Jur9x/Gate/README.md

# Gate
Maturitní projekt - *modelGate*

## Cíle:
* vytvoření modelu brány
* otevírání pomocí dálkového ovládání
* senzor na zamezení zavření

## Možné doplnění:
* otevírání na autentizaci spz
* overview v aplikaci na mobilu

## Použité technologie:

## Zdroje:
