Jur9x/Gate/dokumentace/sablona-zaverecne-prace.pdf

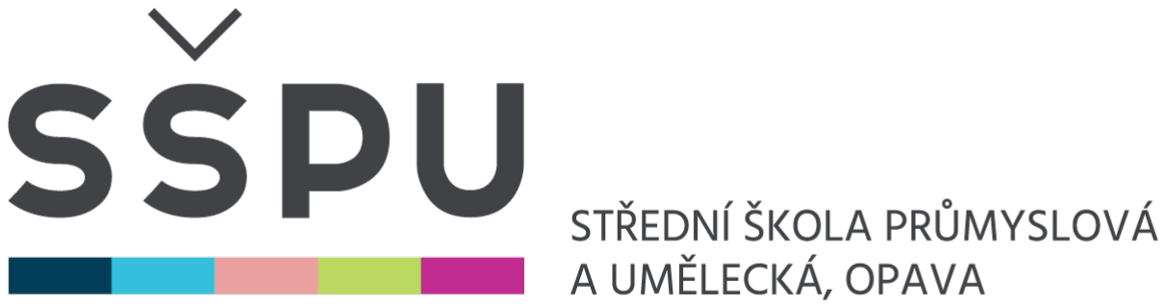
[picture p11: figure]

# ZÁVERE ˇ CNÁ STUDIJNÍ PRÁCE ˇ

### dokumentace

# modelGate

### posuvná brána s elektrickým pohonem

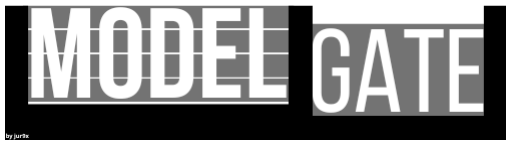
[picture p12: figure]

Autor: | Jiˇrí Ryba
Obor: | 18-20-M/01 INFORMACNÍ TECHNOLOGIE ˇ
se zameˇˇrením na pocíta ˇ cové sít ˇ | e a programování ˇ
Trída: ˇ | IT4
Školní rok: 2023/24

## Podekování ˇ

Rád bych podekoval u ˇ | citel˚um Mgr. Marcelu Godovskému a Mgr. Marku Lu ˇ | cnému za je- ˇ
jich pomoc s projektem, jelikož mi poskytovali soucástky a cenné rady. ˇ

### Prohlášení

Prohlašuji, že jsem závere ˇ cnou práci vypracoval samostatn ˇ | e a uvedl veškeré použité in- ˇ
formacní zdroje. ˇ
Souhlasím, aby tato studijní práce byla použita k výukovým a prezentacním ú ˇ | cel˚um na ˇ
Stˇrední pr˚umyslové a umelecké škole v Opav ˇ | e, Praskova 399/8. ˇ

V Opave 1. 1. 2024 ˇ
Podpis autora

## Abstrakt

Projekt se zameˇˇruje na kompletní realizaci posuvné brány s elektrickým pohonem, zahrnující návrh, modelování, sestavení a programování. Je zde využit mikrokontrolér Ar-
duino Nano, který umožnuje integraci s dálkovým ovládáním, koncovými spína ˇ | ci a sen- ˇ
zorem pohybu. Výsledkem projektu je plne funk ˇ | cní 3D model posuvné brány, schopný ˇ
reagovat na vstupy a poskytující efektivní automatizaci otevírání a zavírání.

### Klícová slova ˇ

Arduino Nano, modelování, programování, sestavení . . .

## Abstract

The project focuses on the complete implementation of an electrically operated sliding gate, including design, modelling, assembly and programming. An Arduino Nano microcontroller is used, which allows integration with remote control, limit switches and motion sensor. The project results in a fully functional 3D model of a sliding gate, capable of responding to inputs and providing efficient automation of opening and closing.

### Key words

Arduino Nano, modelling, programming, assembling . . .

# Obsah

Úvod | 5
1 Tvorba modelu | 6
1.1.1 | Výber softwaru | | 6 ˇ
1.1.5 | Modelování ozubeného kolecka a ozubené lišty | | 8 ˇ
1.1.6 | Modelování desticek a ˇ | cepi ˇ | cek | | 9 ˇ
2 Hardware | 11
3 Funkce modelu brány | 13
Záver | 18 ˇ

## ÚVOD

Cílem tohoto projektu bylo promenit myšlenku v realitu. Jednoho dne, když jsem ˇ | | ˇrešil
stavbu skutecné posuvné brány na rodinném pozemku, m ˇ | e napadlo, že bych podobný ˇ
koncept mohl zkusit vytvoˇrit jako menší projekt. Po schválení nápadu od všech ucitel˚u ˇ jsem se do toho pustil.

Pro samotné provedení modelu jsem vytvoˇril 3D modely, které mi vytiskl pan ucitel ˇ Mgr. Marcel Godovský na 3D tiskárne. Vytisknuté modely poskytly fyzickou podobu ˇ brány a umožnily snadné sestavení. Programování mikrokontroléru Arduino Nano bylo
klícovým krokem k dosažení ovládání brány. Vytvo ˇ | ˇril jsem ˇrídící algoritmus, který umož-
nuje plynulé otevírání a zavírání brány v reakci na externí podn ˇ | ety, nap ˇ | ˇríklad signály ze
snímac˚u nebo dálkového ovlada ˇ | ce. ˇ

Dokumentace obsahuje použité komponenty, zapojení a zp˚usob programování mikrokontroléru. Krome toho jsou zahrnuty i možné vylepšení projektu. Tato dokumentace slouží ˇ jako pr˚uvodce pro každého, kdo má zájem o pochopení a reprodukci podobného projektu posuvné brány s využitím Arduino technologie.

## 1 TVORBA MODELU

### 1.1 3D MODELOVÁNÍ

### 1.1.1 Výber softwaru ˇ

Pˇri výberu modelovacího softwaru pro m˚uj projekt jsem m ˇ | el na výb ˇ | er mezi n ˇ | ekolika ˇ
možnostmi, mezi nimiž byly klícovými kandidáty 3DS Max, Blender a Autodesk Inven- ˇ tor. Po d˚ukladném zvážení všech faktor˚u jsem se rozhodl pro Autodesk Inventor.

### 1.1.2 Výhody a nevýhody Autodesk Inventoru

Rozhodl jsem se využít Autodesk Inventor, díky mé pˇredchozí zkušenosti s tímto programem. Tato volba mi umožnila efektivní modelování bez nutnosti ucení se nového soft- ˇ waru. Díky studentské licenci poskytnuté školou jsem nemusel platit za software. Autodesk Inventor, specializovaný na inženýrství a konstrukci, odpovídá potˇrebám mého projektu s parametrickým modelováním a vhodnými nástroji. I když m˚uže být v umeleckém ˇ
modelování omezený ve srovnání s nekterými um ˇ | eleckými softwary, pro mé konkrétní ˇ
potˇreby a s ohledem na rychlý a efektivní postup modelování s minimální casovou inves- ˇ ticí byla tato volba rychlá a optimální.

### 1.1.3 Modelování konstrukce

V pˇrípade b ˇ ežné brány se brána y obvykle pohybuje po kole ˇ | cku a je usm ˇ | erˇ nována vá- ˇ
lecky. S t ˇ | emito dv ˇ | ema problémy jsem se musel vypo ˇ | ˇrádat. První výzvu jsem ˇrešil tím, že
jsem namísto kolecka vytvo ˇ | ˇril trojúhelníkovou drážku, po které brána jezdí. Díky nízké
váze brány není tˇrení témeˇˇr žádné, což je ideální. Druhý problém jsem eliminoval tím,
že jsem nahradil válecky pevnými body v konstrukci. Nakonec jsem vytvo ˇ | ˇril místa pro
motor, koncové spínace, senzor pohybu a drážky pro desti ˇ | cky. ˇ


Obrázek 1.1: Model konstrukce

### 1.1.4 Modelování brány

V procesu modelování brány jsem vytvoˇril samotnou bránu, vybavil ji trojúhelníkovou drážkou pro pojezd a výstupkem pro kontakt s koncovým spínacem. ˇ


Obrázek 1.2: Model brány

### 1.1.5 Modelování ozubeného kolecka a ozubené lišty ˇ

Pro ozubené kolecko jsem vytvo ˇ | ˇril obdélníkovou díru pro umístení motoru a kolem ob- ˇ
vodu kola jsem vytvoˇril zuby. Ozubená lišta má stejnou délku jako brána a je opatˇrena
zuby shodnými s temi na ozubeném kole ˇ | cku. ˇ


Obrázek 1.3: Model ozubeného kolecka ˇ


Obrázek 1.4: Model ozubené lišty

1.1.6 Modelování desticek a ˇ | cepi ˇ | cek ˇ
Na desticky jsem p ˇ | ˇridal malé výcnˇ elky na obou koncích, vytvá ˇ | ˇrející malý rozestup mezi
jednotlivými destickami. V ˇ | cepi ˇ | ckách je vyhrazeno místo pro LED diody a prostor pro ˇ
drátky. Tyto drátky vedoucí k diodám jsou oddeleny tak, aby nedošlo k dotyku mezi klad- ˇ ným a záporným pólem.


Obrázek 1.5: Model desticky ˇ


Obrázek 1.6: Model cepi ˇ cky ˇ

## 1.2 3D TISK

3D tisk je inovativní výrobní proces, který umožnuje vytvá ˇ | ˇret tˇrírozmerné objekty vrstvu ˇ
po vrstve na základ ˇ | e digitálního modelu. Tento postup eliminuje pot ˇ | ˇrebu tradicního od- ˇ
stranování materiálu a umož ˇ | nuje vytvá ˇ | ˇret komplexní a pˇresné objekty s r˚uznorodými ge-
ometriemi. 3D tisk m˚uže využívat r˚uzné materiály, vcetn ˇ | e plast˚u, kov˚u, keramiky a bio- ˇ
logických tkání, což poskytuje široké možnosti aplikací od pr˚umyslové výroby a prototypování po zdravotní péci a výzkum. Tento inovativní proces zrychluje vývojové cykly ˇ a umožnuje tvorbu unikátních a složitých design˚u s minimálním odpadem. ˇ

### 1.3 SESTAVOVÁNÍ MODELU

Pˇripevnil jsem ozubenou lištu na bránu. Motor s ozubeným koleckem, desti ˇ | cky, ˇ | cepi ˇ | cky, ˇ
koncové spínace a senzor pohybu jsem p ˇ | ˇrilepil na vytiskutý model pomocí tavící pistole.
Nakonec jsem celý model pˇrilepil na dˇrevené desky, kde jsem rovn ˇ | ež p ˇ | ˇridal dve kontaktní ˇ
pole, h-m˚ustek a následne vše zapojil. ˇ


Obrázek 1.7: Ukázka sestavení modelu

## 2 HARDWARE

Výber hardwaru prob ˇ | ehl rychle a jednoduše, nebot’ jsem se rozhodl použít Arduino Nano, ˇ
které jsme již využívali ve škole. Následne mi chyb ˇ | ely pouze n ˇ | ekteré komponenty, které ˇ
mi vstˇrícne poskytl pan u ˇ | citel Mgr. Marcel Godovský. ˇ

### 2.1 SEZNAM POUŽITÉHO HARDWARU

1x Arduino Nano Mikrokontrolér

2x DM00 (DM 03S) Koncové spínaceˇ

1x L298N H-M˚ustek, umožnuj ˇ e mˇ enit polarity motoru ˇ

1x 5V motor

3x LED

3x 330R Rezistor

3x 1k Rezistor

1x HW-201 Senzor pohybu

1x VS1838B IR pˇrijímacˇ

1x Vytisknutá konstrukce

1x Vytisknutá brána

1x Vytiskunté ozubené kolecko ˇ

1x Vytisknutá ozubená tycˇ

4x Vytisknuté plotové desticky ˇ

3x Vytisknuté cepi ˇ cky na plot ˇ

### 2.2 SCHÉMA HARDWARU

Schéma je koncipováno s cílem dosáhnout co nejvetší p ˇ ˇrehlednosti, a proto se nemusí shodovat s reálným uspoˇrádáním komponent v modelu.


Obrázek 2.1: Schéma zapojení

### 2.3 ARDUINO

Arduino je open-source projekt, který je založen na snadno použitelném hardwaru a soft-
waru. Arduino desky mají schopnost císt r˚uzné vstupy, jako nap ˇ | ˇríklad svetlo na senzoru, ˇ
stisknutí tlacítka nebo dokonce zprávy z Twitteru, a p ˇ | ˇremeˇnovat je na odpovídající vý- ˇ
stupy. To m˚uže zahrnovat aktivaci motoru, rozsvícení LED nebo dokonce publikaci ne-ˇ ceho online. S Arduino deskou m˚užete komunikovat pomocí instrukcí, které posíláte do ˇ mikrokontroléru. K tomu využíváte programovací jazyk Arduino a speciální vývojové prostˇredí Arduino Software (IDE).

### 2.4 PROBLÉMY S HARDWAREM

Ovladac ne ˇ | cekan ˇ | e p ˇ ˇrideloval r˚uzné kódy na jedno tla ˇ | cítko, což bylo trochu zvláštní. Toto ˇ
se stávalo po urcité dob ˇ | e testování, a ob ˇ | cas to fungovalo, zatímco jindy ne. Opravit tento ˇ
problém se ukázalo být složitejší, než jsem p˚uvodn ˇ | e o ˇ cekával, a tak jsem se rozhodl ho ˇ
zatím neˇrešit. Celkove však ovlada ˇ | c pracuje správn ˇ | e p ˇ ˇribližne 90 % ˇ | casu. ˇ
Problém s motorem a proudem vznikl, když jsem p˚uvodne plánoval napájet motor p ˇ | ˇres
Arduino. Nicméne jsem si neuv ˇ | edomil, že Arduino poskytuje pouze omezený proud (asi ˇ
200 mA), zatímco motor, který používám, vyžaduje alespon 500 mA. To m ˇ | e vedlo k hle- ˇ
dání externího napájení, a nakonec mi pan ucitel Mgr. Marcel Godovský poskytl 5V zdroj, ˇ což je výhodné, protože z nej mohu napájet i Arduino. ˇ

## 3 FUNKCE MODELU BRÁNY

Model brány má nekolik základních funkcí, které by m ˇ | el obsahovat každý bránový sys- ˇ
tém. To zahrnuje otevírání, zavírání a zastavování na povel z dálkového ovládání. Dále
umí zastavit na základe reakce na senzor pohybu. Krom ˇ | e toho model disponuje t ˇ | ˇremi
LED diodami, které signalizují aktuální stav brány.
3.1 OTEVRENÍ ˇ | , ZAVRENÍ A ZASTAVENÍ ˇ
Pro aktivaci jedné z techto funkcí je nezbytné stisknout p ˇ | ˇríslušné tlacítko na dálkovém ˇ
ovládání. Následne IR p ˇ | ˇrijímac detekuje signál a p ˇ | ˇriˇradí mu specifický kód. Na základeˇ
tohoto kódu tlacítka a dalších podmínek, jako jsou koncové spína ˇ | | | ce nebo senzor pohybu, ˇ
rozhodne programový kód, zda se motor má roztocit ˇ ci nikoli. V p ˇ | ˇrípade rozhodnutí pro ˇ
roztocení je do motoru správn ˇ | e p ˇ ˇrivedeno napetí, aby se pohyboval ve správném sm ˇ | | | eru. ˇ
Aby byl IR pˇrijímac funk ˇ | cní, je t ˇ | ˇreba zahrnout knihovnu | IRremote.h , nastavit pin
pˇripojený k pˇrijímaci (nap ˇ | ˇríklad | const int RECV_PIN = 12 | ), tento pin definovat pro
IRrecv ( IRrecv irrecv(RECV_PIN) ), vytvoˇrit promennou pro ukládání výsledk˚u a ak- ˇ
tivovat ho pomocí | irrecv.enableIRIn() . Podmínka | if | uloží kód do | results , po-
kud obdrží signál.

# i n c l u d e < IRremote . h> / / knihovna k IR p r i j i m a c i

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

Pro další postup je nutné konfigurovat koncové spínace; o senzoru pohybu bude podrob- ˇ
neji pojednáno v následující ˇ | cásti. Nastavení pin˚u je identické s tím u IR p ˇ | ˇrijímace, s tím ˇ
rozdílem, že v setupu nastavíme tyto dva piny jako | INPUT .

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

/ / p o v o l e n i pinu , p i s e se do s e t u p u pinMode ( Button_Levy_Pin , INPUT ) ;
pinMode ( Button_Pravy_Pin , INPUT ) ;
Vytvoˇríme promenné pro koncové spína ˇ | ce a senzor, abychom zabránili duplikaci kódu. ˇ

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

Vytvoˇríme podmínky pro spouštení a zastavování motoru, kde prom ˇ | enná ˇ | n | urcuje stav ˇ
motoru. První podmínka se ptá, zda je senzor aktivní ci ne. Druhá podmínka kontroluje, ˇ
zda je aktivní | STOP_CODE . Tˇretí podmínka zkoumá, zda není aktivní ani | OPEN_CODE ,
ani | CLOSE_CODE . S každým pr˚uchodem smyckou se kód resetuje, a tím pádem tato pod- ˇ
mínka zacne platit, což umožní koncovým spína ˇ | c˚um zastavit motor p ˇ | ˇri jejich aktivaci.
Ctvrtá podmínka se ptá, zda je vždy jeden spína ˇ | c sepnutý a druhý nikoli. Toto zajistí ˇ
zastavení motoru, když se jeden ze spínac˚u sepne. Pátá podmínka ov ˇ | eˇˇruje, zda je asponˇ
jeden nebo žádný spínac sepnutý. Toto je implementováno z d˚uvodu, že brána je obvykle ˇ
na konci a má spínac sepnutý, nebo je uprost ˇ | ˇred cesty a spínace nejsou sepnuté. ˇ

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

Tocení motoru ve správném sm ˇ | eru vy ˇ | ˇrešíme porovnáním, které tlacítko na ovlada ˇ | ci bylo ˇ
stisknuto, a pˇriˇradíme odpovídající smer do prom ˇ | enné ˇ | direction . Pˇri tomto procesu
také resetujeme promennou ˇ | results , abychom zajistili správnou funkcnost programo- ˇ
vého kódu, jak je zmíneno v posledním odstavci. ˇ

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

### 3.2 SENZOR NA POHYB

U senzoru pohybu musíme definovat pin, ke kterému je pˇripojen, a v setupu povolit tento pin jako INPUT .

c o n s t i n t IR_Senzor_Pohybu_Pin = 9 ;
/ / p o v o l e n i pinu , p i s e se do s e t u p u
pinMode ( IR_Senzor_Pohybu_Pin , INPUT ) ;
Kontrolujeme stav senzoru a sledujeme, zda je ve stavu | HIGH | nebo | LOW . Vzhledem
k tomu, že stav | LOW | signalizuje aktivitu, když je senzor v tomto stavu, motor se nespustí
a nastavíme kód tlacítka na ˇ | STOP_CODE . Tímto zp˚usobem zajistíme, že se motor oka-
mžite zastaví a nebude znovu spoušt ˇ | en. Tato opat ˇ | ˇrení jsou implementována tak, aby se
pˇredešlo situaci, kdy by brána reagovala na krátkodobou aktivaci senzoru, napˇríklad pˇri pr˚uchodu dítete, a brána by se zastavila a ihned znovu spustila. Tímto zp˚usobem je zajiš- ˇ teno, že brána z˚ustane zastavená po detekci aktivity. ˇ

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

### 3.3 LED INDIKÁTORY A MOTOR

Zapnutí motoru a LED na základe prom ˇ | enných ˇ | n | a | direction | zacíná tím, že znovu ˇ
definujeme a nastavujeme piny. Tyto piny jsou poté povoleny v setupu, pˇricemž všechny ˇ jsou nastaveny jako OUTPUT .

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

/ / p o v o l e n i pinu , piseme do s e t u p u pinMode ( LED_Uprostred_Pin , OUTPUT ) ; pinMode ( LED_Vlevo_Pin , OUTPUT ) ; pinMode ( LED_Vpravo_Pin , OUTPUT ) ; pinMode ( Motor_Pravy_Pin , OUTPUT ) ;
pinMode ( Motor_Levy_Pin , OUTPUT ) ;
Pro aktivaci motoru potˇrebujeme nastavit jeden pin na | HIGH | a druhý na | LOW . Tuto kon-
figuraci ˇrídí promenná ˇ | n , která urcuje, zda se motor má to ˇ | cit, a prom ˇ | enná ˇ | direction ,
která urcuje sm ˇ | er otá ˇ | cení. Pro aktivaci LED diod postupujeme obdobn ˇ | e. Nakonec p ˇ | ˇri-
dáváme | delay(180) | pro správnou funkcnost koncových spína ˇ | c˚u, které reagují p ˇ | ˇríliš
rychle. Toto zpoždení bylo zavedeno k úprav ˇ | e problém˚u s p ˇ | ˇrílišnou citlivostí spínac˚u, ˇ
které vedly k nežádoucím krátkým pohyb˚um brány.

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

i f ( n == 1) {
d e l a y ( 1 8 0 ) ;
}

### 3.4 OPTIMALIZACE KÓDU

Pro optimalizaci kódu zacneme definováním prom ˇ | enných úpln ˇ | e naho ˇ | ˇre (krome kniho- ˇ
ven). Následne pokra ˇ | cujeme funkcí ˇ | setup() , kde povolujeme piny a definujeme akce.
Dále máme vlastní funkci | handleLEDsAndMotors() , která se stará o zapínání pin˚u pro
LED diody a motor. Následuje funkce | checkIRSensorAndButtons() , kde se nachází
rozsáhlá sada podmínek. Dále je tu funkce | processIRResults() , ve které urcujeme ˇ
smer. Na záv ˇ | er máme funkci ˇ | loop() , kde jsou volány všechny vlastní funkce, a kód
ovladace je uložen do prom ˇ | enné ˇ | results .

vo id lo op ( ) {
i f ( i r r e c v . decode (& r e s u l t s ) ) { i r r e c v . resume ( ) ;
}
checkIRSensorAndButtons ( ) ;
p r o c e s s I R R e s u l t s ( ) ; handleLEDsAndMotors ( ) ;
}

## 3.5 OVLÁDÁNÍ BRÁNY

Pomocí ovladace odesíláme signál, který programový kód vyhodnotí a p ˇ | ˇriˇradí kód tla-
cítka do prom ˇ | enné ˇ | results | ( OPEN_CODE, STOP_CODE, CLOSE_CODE | ). Pokud je kód
tlacítka roven ˇ | OPEN_CODE | a splnují se všechny podmínky, motor se zapne a brána se ote- ˇ
vˇre. V pˇrípade, že kód tla ˇ | cítka odpovídá ˇ | CLOSE_CODE | a všechny podmínky jsou splneny, ˇ
motor se zapne a brána se zavˇre. Pˇri shode s kódem ˇ | STOP_CODE | se nic nestane, motor
z˚ustane vypnutý. Pokud je motor aktivní a senzor pohybu se aktivuje, motor se zastaví a už se nespustí.

## ZÁVERˇ

Cílem projektu bylo vytvoˇrit model posuvné brány s elektrickým pohonem, kterou lze ovládat pomocí dálkového ovládání. Model byl vymodelován v programu Autodesk In-
ventor, následne vytisknut na 3D tiskárn ˇ | e a spolu s hardwarem sestaven. Pro realizaci byl ˇ
využit mikrokontroléˇr Arduino Nano, který byl naprogramován.

Podle mého názoru jsem cíl˚u projektu dosáhl. Behem procesu práce jsem získal doved- ˇ
nosti efektivního modelování v programu Autodesk Inventor a naucil se vhodn ˇ | e vytvá- ˇ
ˇret modely pro snadné 3D tisknutí. Dále jsem zdokonalil své programátorské dovednosti a získal zkušenosti s Arduinem. Pro budoucí vylepšení plánuji pˇridat kameru, která bude
snímat SPZ a na základe t ˇ echto údaj˚u otevírat bránu. Také mám v úmyslu vytvo ˇ | ˇrit mobilní
aplikaci, která bude fungovat jako dálkový ovladac.ˇ

## SEZNAM POUŽITÝCH ZDROJU˚

[1] Citace PRO [online]. Citace.com, 2020 [cit. 2020-08-31]. Dostupné z: https://www.citacepro.com
[2] Arduino [online]. Arduino.cc, 2024 [cit. 2024-1-8]. Dostupné z: https://www. arduino.cc
[3] EasyEDA [online]. easyeda.com, 2024 [cit. 2024-1-8]. Dostupné z: https://easyeda.com/
[4] Autodesk Inventor [online]. autodesk.cz/products/inventor/, 2024 [cit. 2024-1-8]. Dostupné z: https://www.autodesk.cz/products/inventor/
[5] Canva [online]. canva.com, 2024 [cit. 2024-1-9]. Dostupné z: https://www. canva.com

# Seznam obrázk˚u

1.1 Model konstrukce | | 7
1.2 Model brány | | 7
1.3 Model ozubeného kolecka | | 8 ˇ
1.4 Model ozubené lišty | | 8
1.5 Model desticky | | 9 ˇ
1.6 Model cepi ˇ | cky | | 9 ˇ
1.7 Ukázka sestavení modelu | 10
2.1 Schéma zapojení | 12
