Jur9x/Gate/stlonly/modelGateGearv2.stl

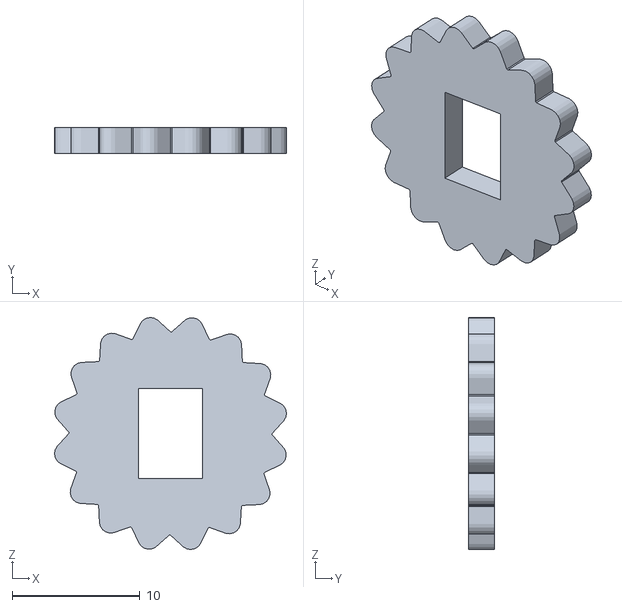
[picture p13: CAD file, 2023-12-04]
stlonly/modelGateGearv2.stl
18.1 x 2.00 x 18.1
