Jur9x/Gate/stlonly/modelGateGearv3.stl

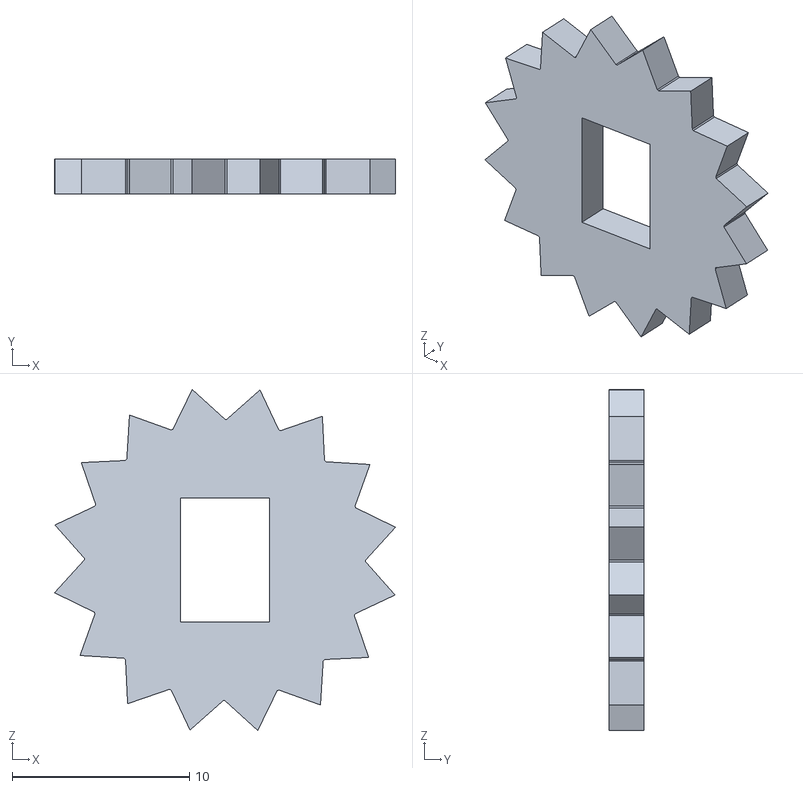
[picture p14: CAD file, 2023-12-04]
stlonly/modelGateGearv3.stl
19.3 x 2.00 x 19.3
