Jur9x/Gate/stlonly/modelGateKonstrukcev3.stl

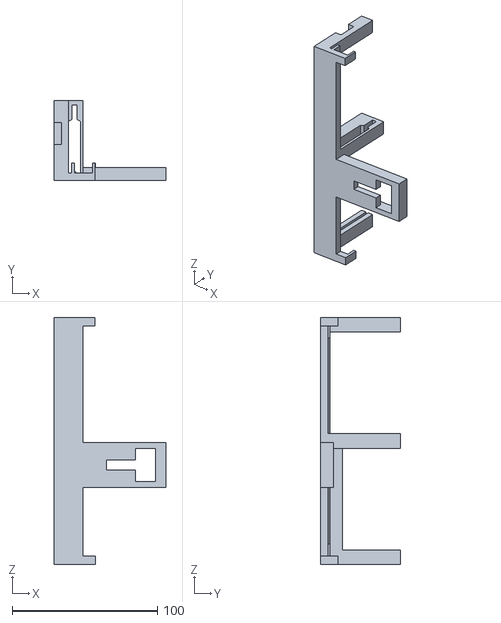
[picture p15: CAD file, 2023-12-04]
stlonly/modelGateKonstrukcev3.stl
76.9 x 55.0 x 170.0
