Jur9x/Gate/stlonly/modelGateGatev2.stl

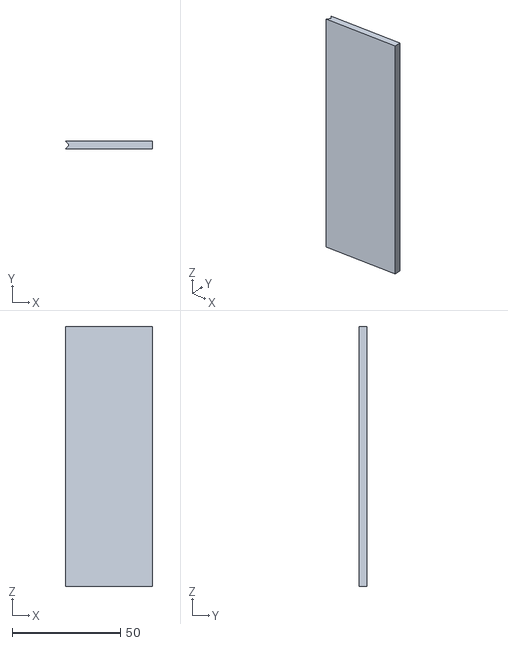
[picture p16: CAD file, 2023-12-04]
stlonly/modelGateGatev2.stl
40.0 x 3.50 x 120.0
