Jur9x/Gate/stlonly/modelGatePoklice1Leava.stl

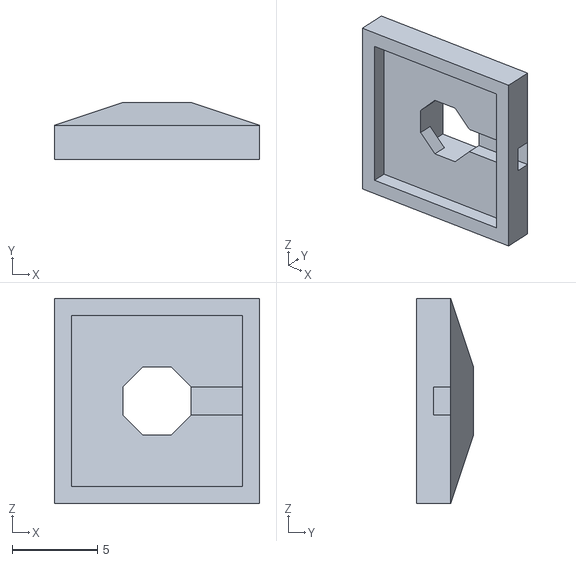
[picture p17: CAD file, 2023-12-04]
stlonly/modelGatePoklice1Leava.stl
12.0 x 3.33 x 12.0
