Jur9x/Gate/stlonly/modelGateGatev3.stl

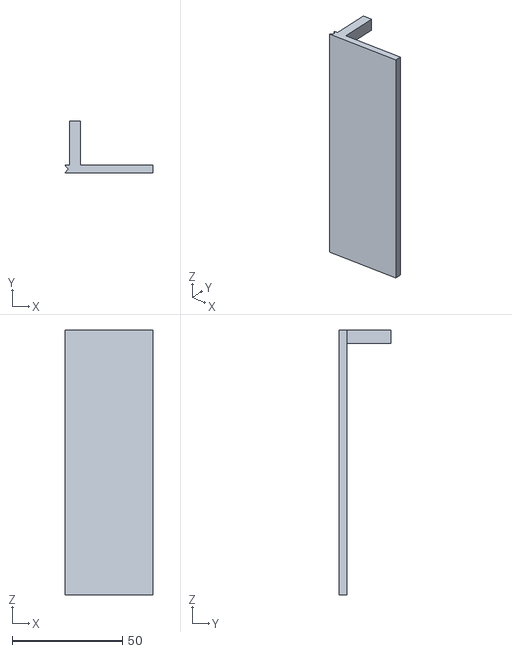
[picture p18: CAD file, 2023-12-04]
stlonly/modelGateGatev3.stl
40.0 x 23.5 x 120.0
