Jur9x/Gate/stlonly/modelGateCoverv2.stl

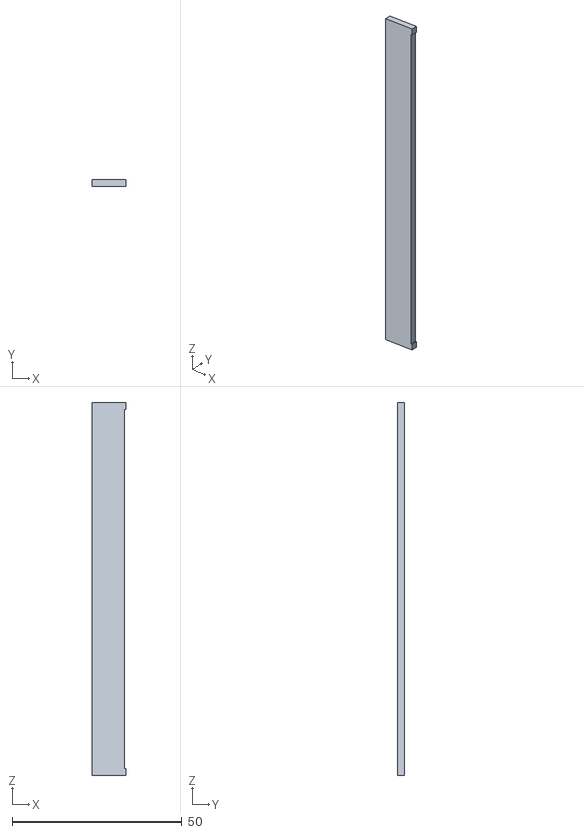
[picture p19: CAD file, 2023-12-04]
stlonly/modelGateCoverv2.stl
10.0 x 2.00 x 110.0
