Jur9x/Gate/stlonly/modelGatePoklice1Prava.stl

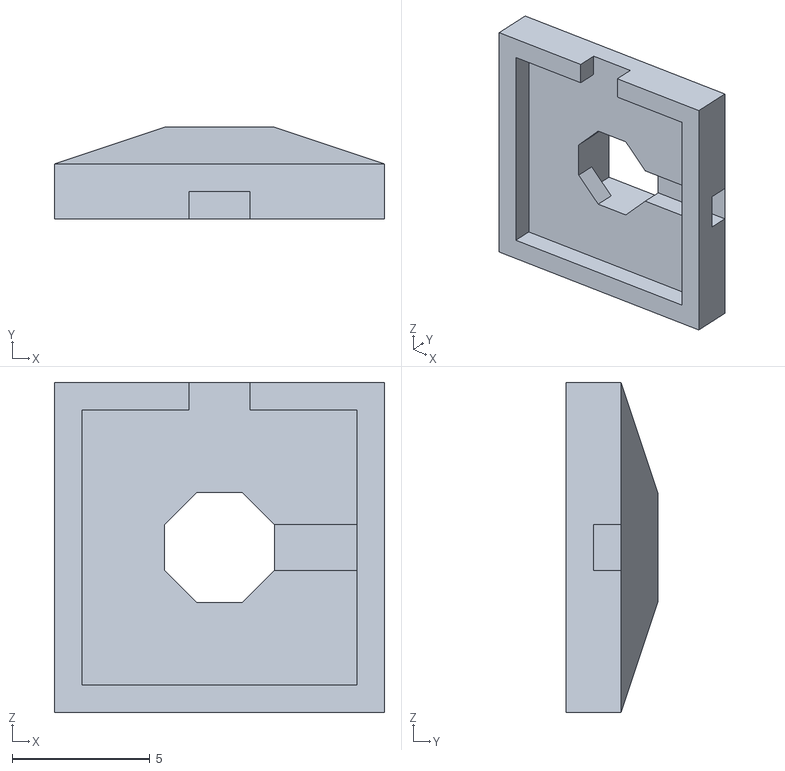
[picture p20: CAD file, 2023-12-04]
stlonly/modelGatePoklice1Prava.stl
12.0 x 3.33 x 12.0
