Jur9x/Gate/stlonly/modelGatePoklice1Prostredni.stl

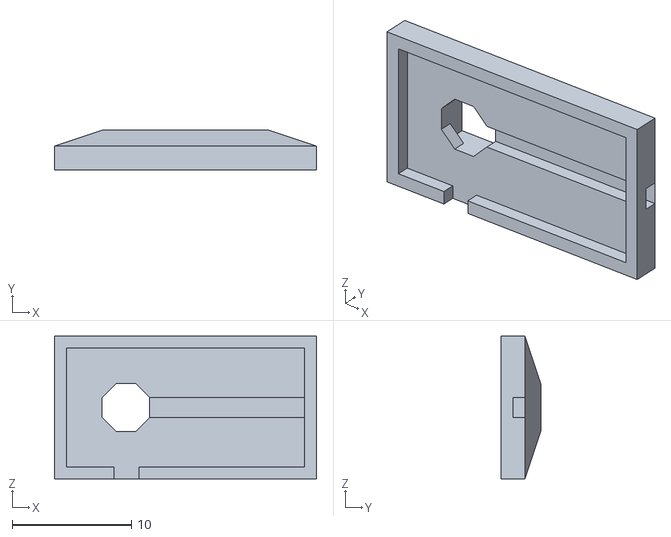
[picture p21: CAD file, 2023-12-04]
stlonly/modelGatePoklice1Prostredni.stl
22.0 x 3.33 x 12.0
