Jur9x/Gate/stlonly/modelGateKonstrukcev4.stl

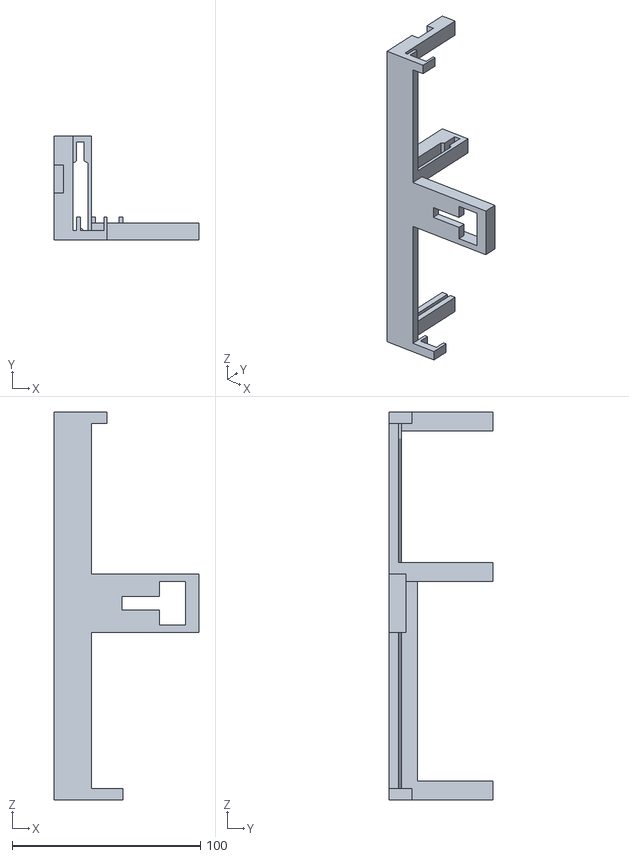
[picture p22: CAD file, 2023-12-04]
stlonly/modelGateKonstrukcev4.stl
76.9 x 55.0 x 206.0
