Jur9x/Gate/stlonly/modelGateGearv4.stl

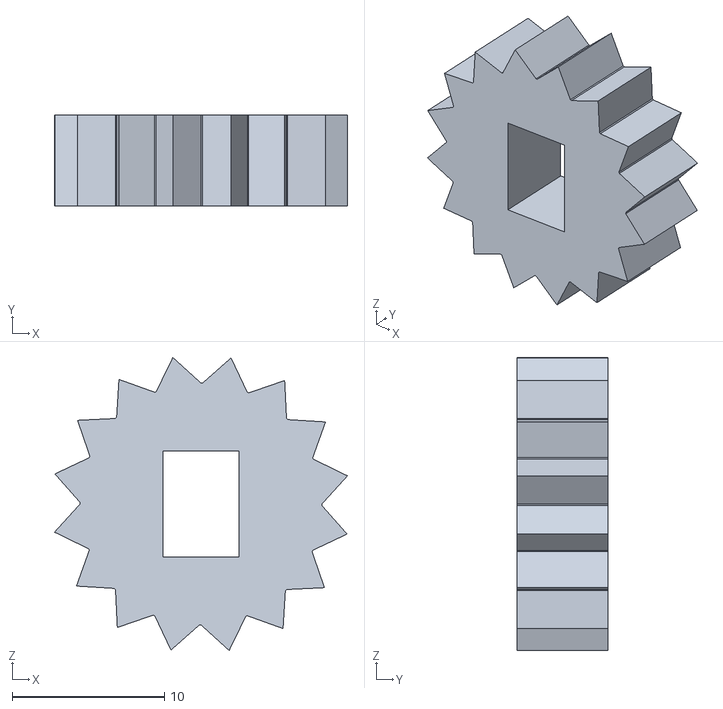
[picture p23: CAD file, 2023-11-19]
stlonly/modelGateGearv4.stl
19.3 x 6.00 x 19.3
