Jur9x/Gate/stlonly/modelGateCover.stl

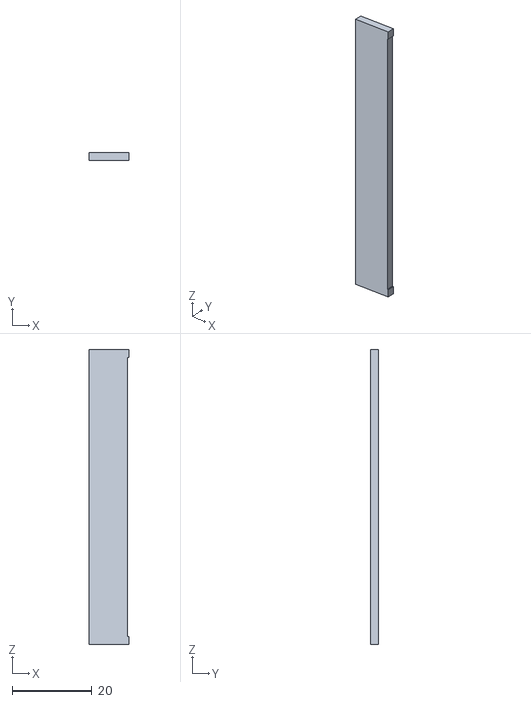
[picture p24: CAD file, 2023-11-19]
stlonly/modelGateCover.stl
10.0 x 2.00 x 74.0
