Jur9x/Gate/stlonly/modelGateKonstrukcev2.stl

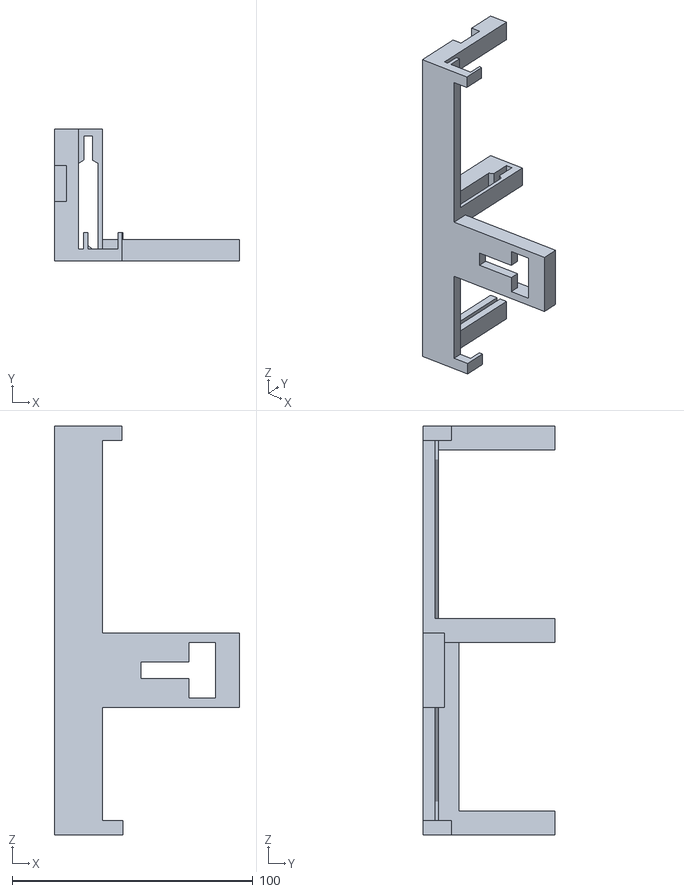
[picture p25: CAD file, 2023-11-19]
stlonly/modelGateKonstrukcev2.stl
76.9 x 55.0 x 170.0
