Jur9x/Gate/stlonly/modelGateZoubkouváTyčv3.stl

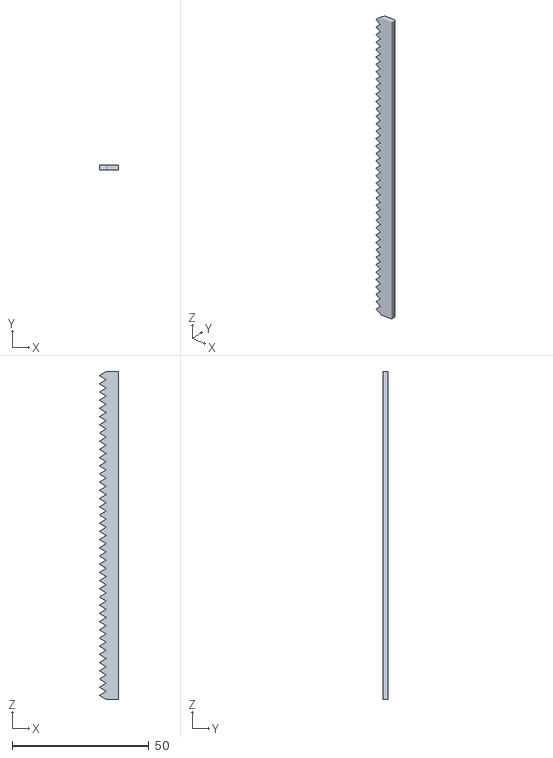
[picture p26: CAD file, 2023-11-19]
stlonly/modelGateZoubkouváTyčv3.stl
7.00 x 2.00 x 120.0
