Jur9x/Gate/stlonly/modelGateGear.stl

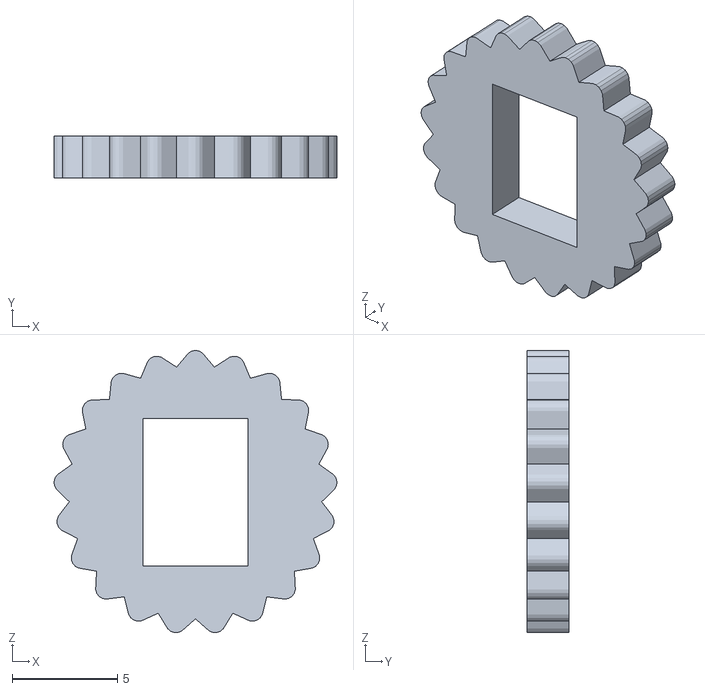
[picture p27: CAD file, 2023-11-04]
stlonly/modelGateGear.stl
13.4 x 2.00 x 13.4
