Jur9x/Gate/stlonly/modelGateGate.stl

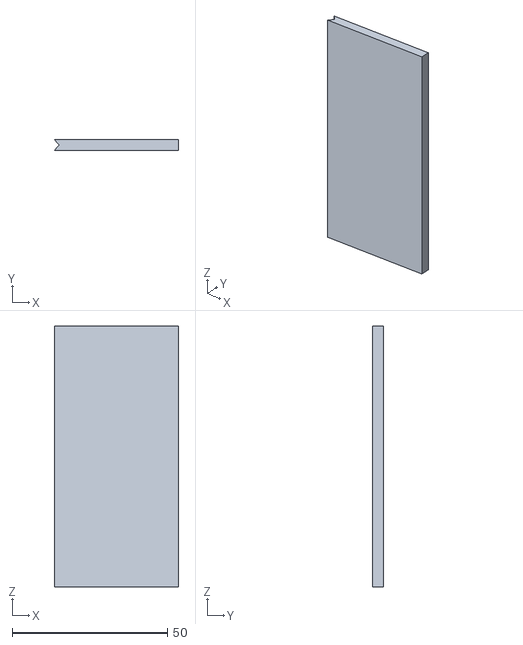
[picture p28: CAD file, 2023-11-04]
stlonly/modelGateGate.stl
40.0 x 3.50 x 84.0
