Jur9x/Gate/stlonly/modelGate.stl

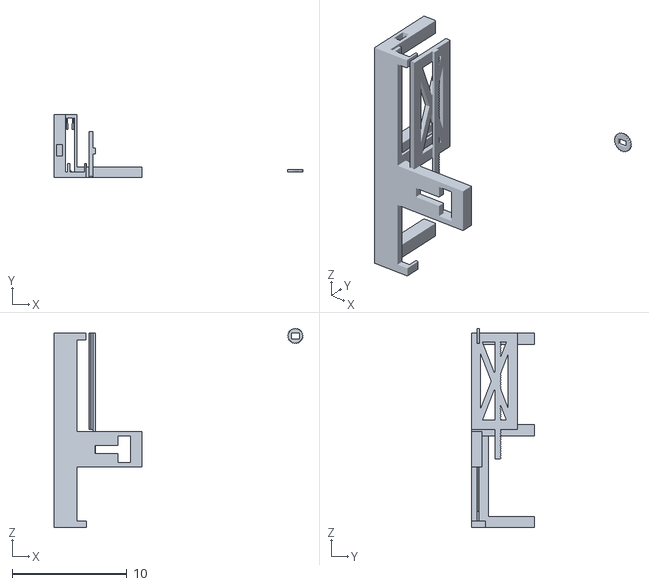
[picture p29: CAD file, 2023-10-30]
stlonly/modelGate.stl
21.7 x 5.50 x 17.4
