Jur9x/Gate/(list of files, cad)

Other CAD files:
stlonly/modelGateKonstrukce.stl
iptonly/modelGate.ipt
iptonly/modelGateCover.ipt
iptonly/modelGateGate.ipt
iptonly/modelGateGear.ipt
iptonly/modelGateKonstrukce.ipt
iptonly/modelGatePoklice1 - kopie (2).ipt
iptonly/modelGatePoklice1 - kopie.ipt
iptonly/modelGatePoklice1.ipt
iptonly/modelGatePoklice1Leava.ipt
iptonly/modelGatePoklice1Prava.ipt
iptonly/modelGatePoklice1Prostredni.ipt
iptonly/modelGateZoubkouváTyč.ipt
stlonly/modelGateZoubkouváTyč.stl
stlonly/modelGateZoubkouváTyčv2.stl
