Jur9x/Gate/changelog-questbook.txt

Changelog >

30.10 první verze modelu brány v inventoru (model brany upload)
4.11 lehce upravena konstrukce, upraveny rozměry modelu, rozděleny částí na jednotlivé soubory (model brany uprava a rozdeleni upload)
8.11 přidán kod na spínače, funkční "zapínání a vypínání" motoru
9-13.11 jsem postupně upravoval kod, napsal jsem kod na snímač pohybu, který funguje a pokoušel jsem se zprovoznit motor, ale nešlo mi to, taky jsem domodeloval všechny potřebné části k fungování brány, designové části a některé designové časti ještě namodeluju
16-25.11 jsem upravoval kod, dostal jsem se konečně k funkčnímu prototypu kodu
29.11 jsem s panem Godovským dořešil modely, snad už budou fungovat.
5.12-27.12 jsem dodělal modely, dopsal kod (až na polofunkční ovladač, ale ten možná ještě vyřeším)
1.1-10.1 vytváření dokumentace
12.1 upload dokumentace
16.1 upload prezentace (pptx formát)

Quest book >

model brány (hotovo)
arduino kod na funkčnost brány (hotovo)
ozkoušet kod a komponenty (hotovo)
zapojit všechno (hotovo)
slepení brány (hotov)
napsat dokumentaci (hotovo)
