Jur9x/Gate/(commit log)

2023-10-30 model brany upload
    upload ipt souboru modelu brány, stl souboru na 3d tisk, a changelog/quest book abych mohl psát co jsem udělal a co ještě ne
    [modelGate.ipt, modelGate.stl]
2023-11-04 model brany uprava a rozdeleni upload
    [modelGate.ipt, modelGate.stl, modelGateGate.ipt, modelGateGate.stl, modelGateGear.ipt, modelGateGear.stl, modelGateKonstrukce.ipt, modelGateKonstrukce.stl]
2023-11-19 19.11 Přidány nové a změněné modely
    [modelGateCover.ipt, modelGateCover.stl, modelGateGear.ipt, modelGateGearv4.stl, modelGateKonstrukce.ipt, modelGateKonstrukcev2.stl, modelGateZoubkouváTyč.ipt, modelGateZoubkouváTyčv3.stl]
2023-12-04 4.12 update modelů, changelogu
    [modelGateCover.ipt, modelGateCoverv2.stl, modelGateGate.ipt, modelGateGatev2.stl, modelGateGatev3.stl, modelGateGearv2.stl, modelGateGearv3.stl, modelGateKonstrukce.ipt]
